PrintXDreams/BambuNRS/hardware/photos/1-1.png

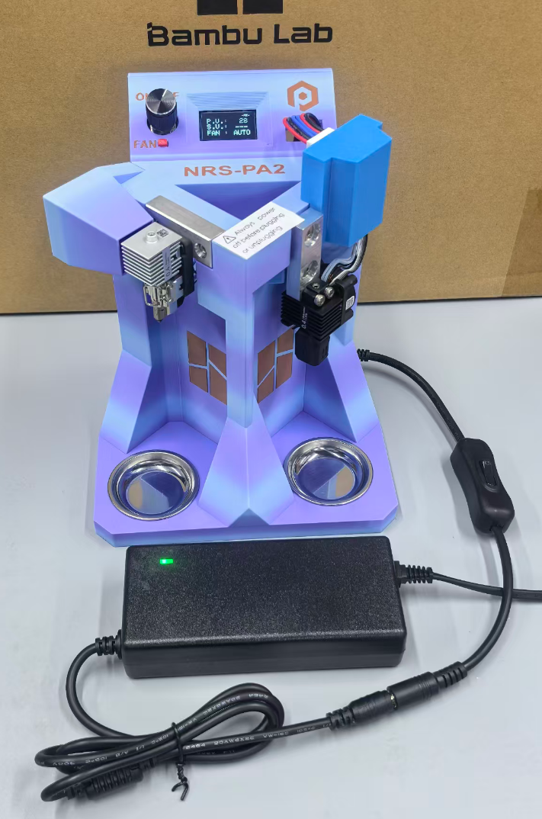
hardware/photos/1-1.png
