PrintXDreams/BambuNRS/hardware/photos/1-2.png

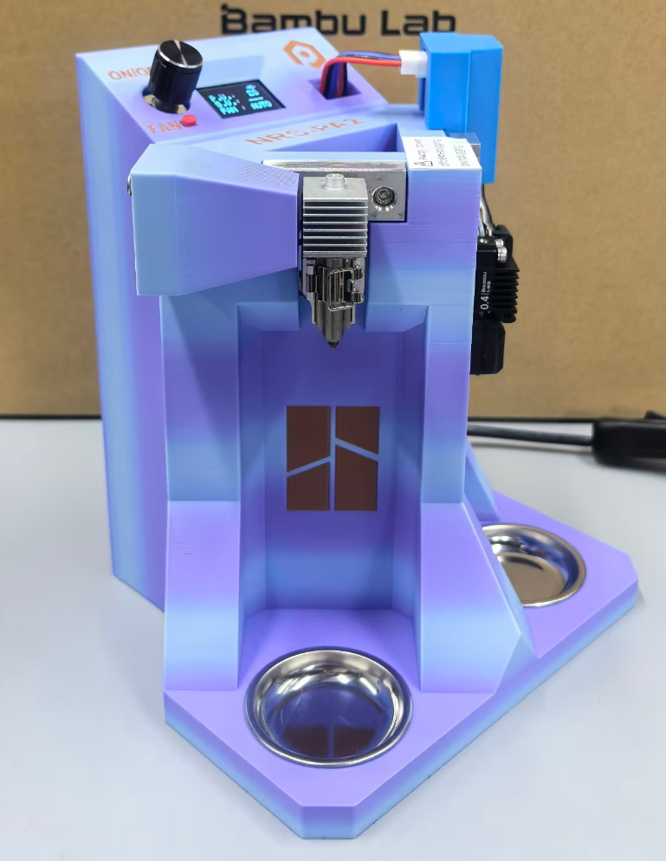
hardware/photos/1-2.png
