PrintXDreams/BambuNRS/hardware/photos/1-3.png

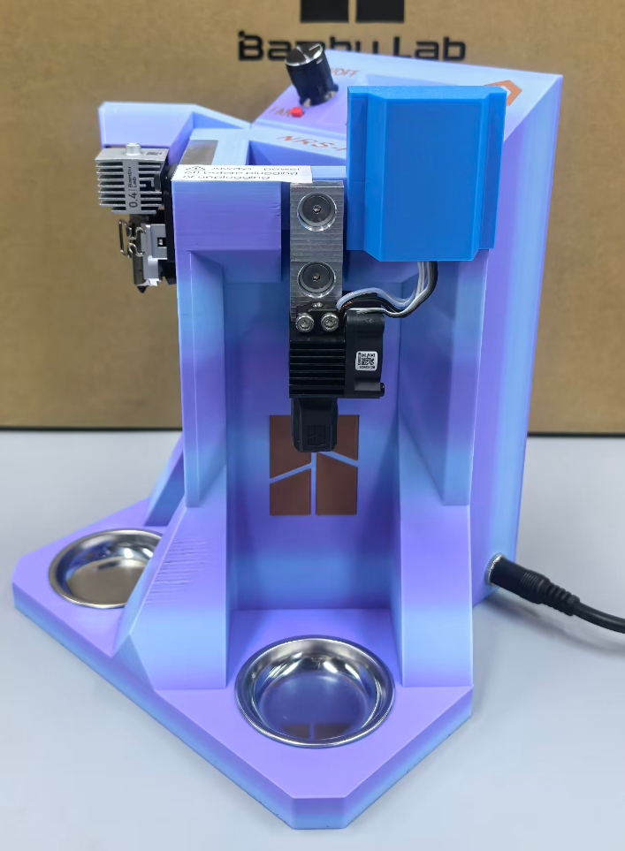
hardware/photos/1-3.png
