PrintXDreams/BambuNRS/hardware/photos/2-1.png

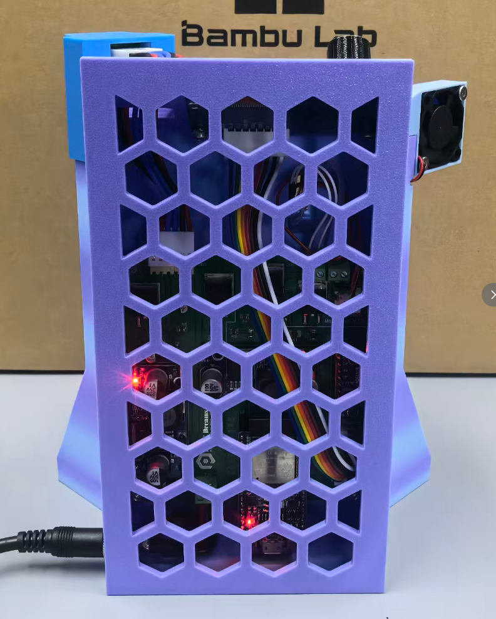
hardware/photos/2-1.png
