PrintXDreams/BambuNRS/hardware/photos/2-2.png

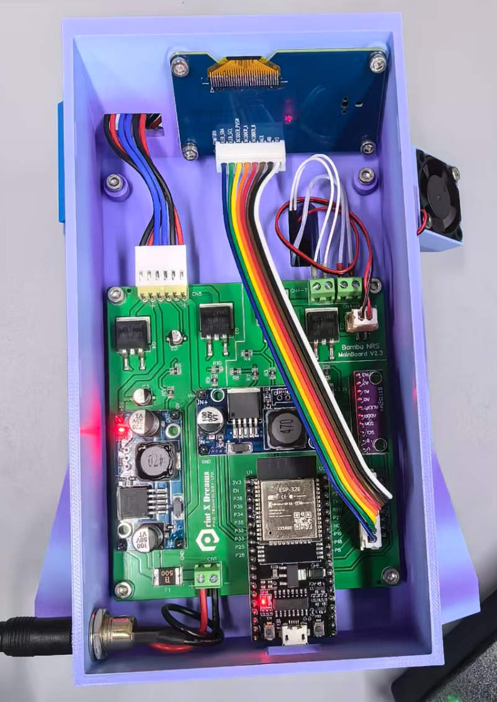
hardware/photos/2-2.png
