PrintXDreams/BambuNRS/hardware/photos/3-1.png

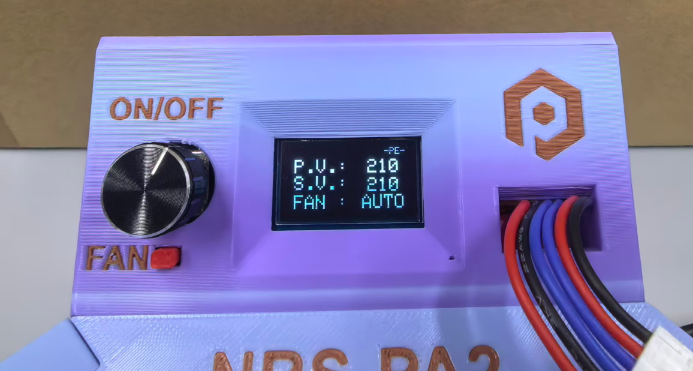
hardware/photos/3-1.png
