PrintXDreams/BambuNRS/hardware/photos/3-2.png

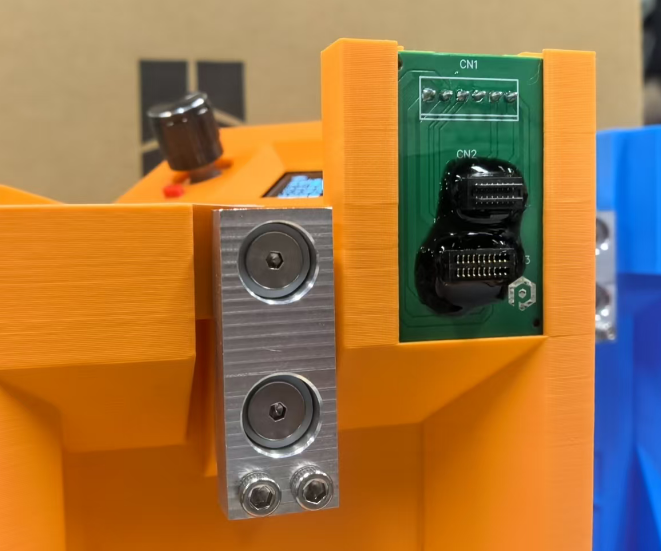
hardware/photos/3-2.png
