PrintXDreams/BambuNRS/hardware/photos/3-3.png

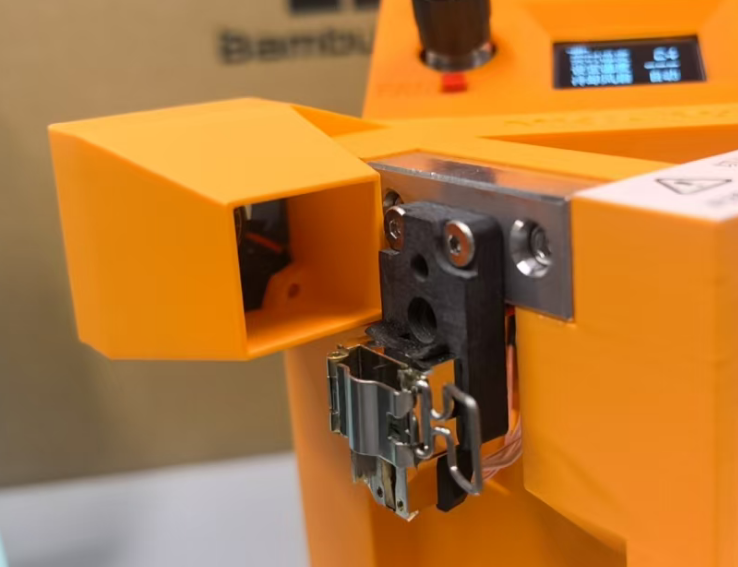
hardware/photos/3-3.png
