PrintXDreams/BambuNRS/hardware/photos/3-4.png

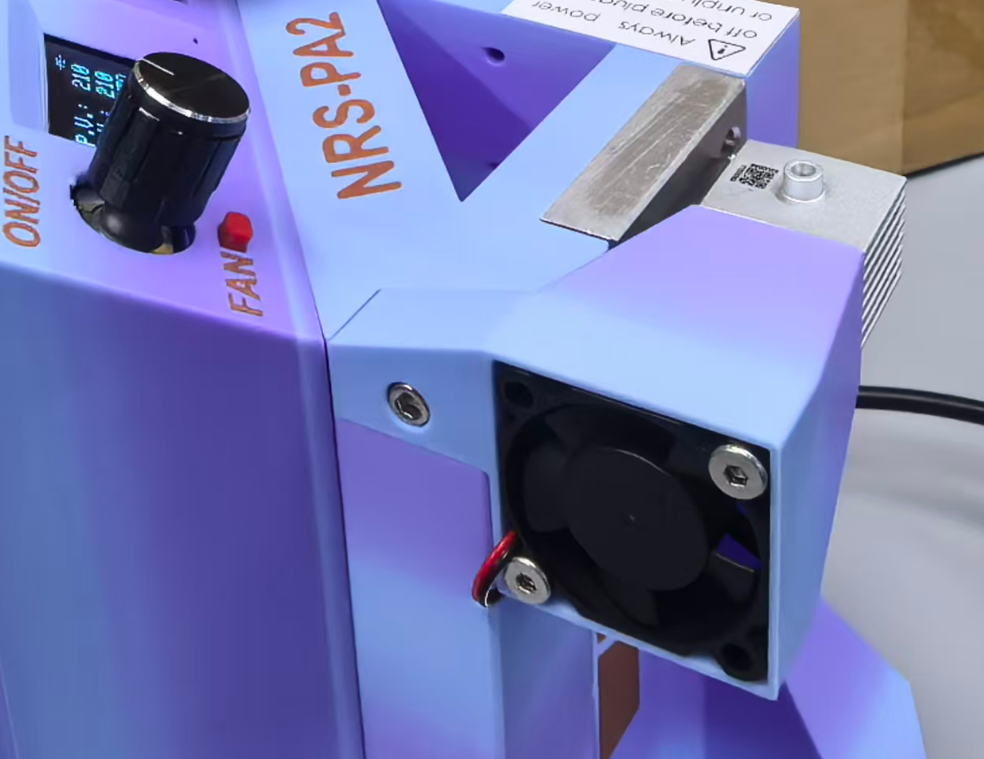
hardware/photos/3-4.png
