PrintXDreams/BambuNRS/hardware/photos/5-1.png

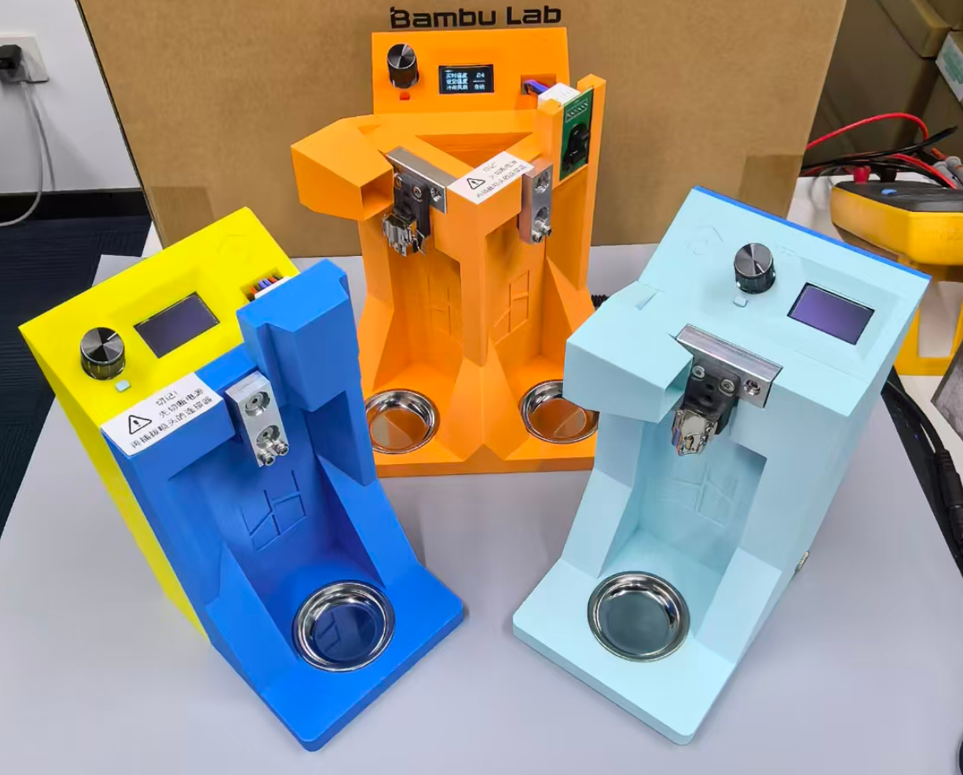
hardware/photos/5-1.png
