PrintXDreams/BambuNRS/docs/assembly/parts-selection.md

# Parts Selection Notes

> [!NOTE]
> Work in progress - content will be added incrementally.

## Electronics

### ESP32 Development Board

**Model:** ESP-32-32E

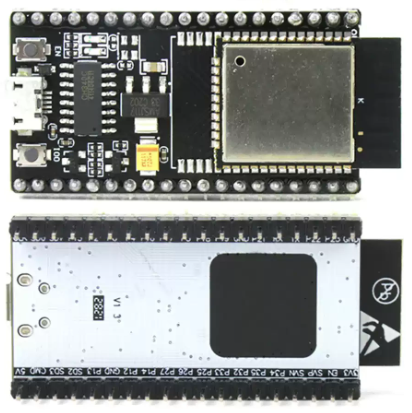
[picture p12: docs/assembly/img/esp32-devkit.png]
ESP-32-32E


<!-- Notes on ESP32 -->

### OLED Display + Rotary Encoder Module

**Model:** 0.96" OLED Display + EC11 Rotary Encoder Combo Module with IIC Interface

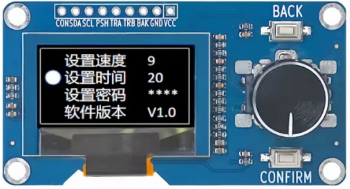
[picture p13: docs/assembly/img/oled-rotary-encoder-module.png]
OLED+EC11


<!-- Notes on OLED and rotary encoder -->

### DC-DC Buck Power Module

**Model:** LM2596S Fixed Output 3.3V / LM2596S Fixed Output 5V (P-series only), 3A

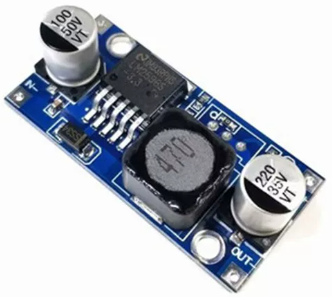
[picture p14: docs/assembly/img/lm2596-dc-dc-module.png]
LM2596


<!-- Notes on DC-DC module -->

### DC Cooling Fan (A-series only)

**Model:** 2510, 24VDC, XH2.54 Connector

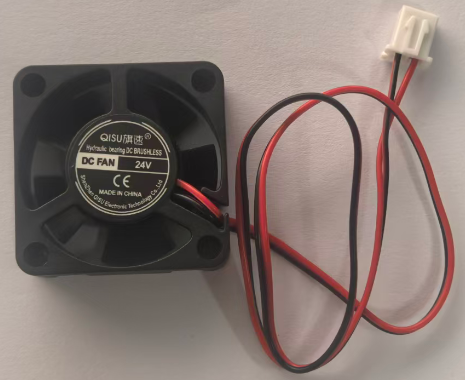
[picture p15: docs/assembly/img/dc-fan-2510.png]
DC Fan 2510


<!-- Notes on DC fan -->

### A1 Hotend Heater Component

**Model:** FAH012 (Third-party compatible)

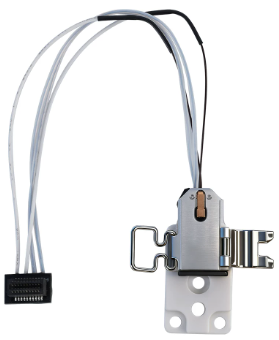
[picture p16: docs/assembly/img/fah012-heater.png]
FAH012


<!-- Notes on A1 hotend heater -->

### DC Power Supply

**Model:** 24V 5A, DC 5.5*2.5mm Connector

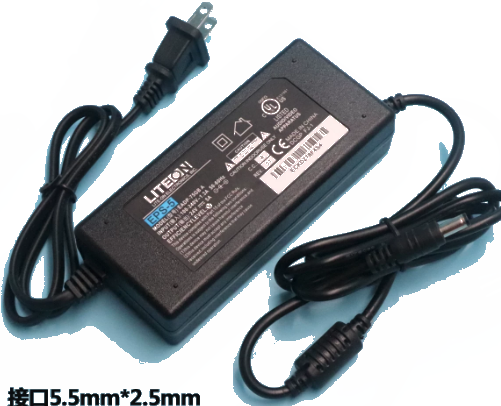
[picture p17: docs/assembly/img/dc-power-24v5a.png]
DC Power 24V5A


<!-- Notes on DC power supply -->

### DC Switch Cable

**Model:** DC 5.5*2.5mm, 5A

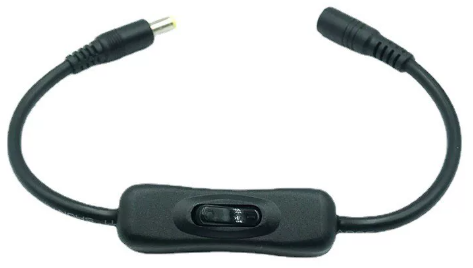
[picture p18: docs/assembly/img/dc-switch-cable.png]
DC Switch Cable


<!-- Notes on DC switch cable -->

### DC Power Socket

**Model:** DC-099, 5.5×2.5, with 10cm wire

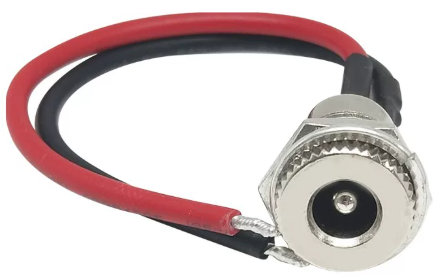
[picture p19: docs/assembly/img/dc-power-socket.png]
DC Power Socket


<!-- Notes on DC power socket -->

## Fasteners and Standard Parts

### Hexagon Socket Screws (内六角螺丝)

**Models:**
- M3×15 — For PCB mounting
- M3×12 — For A-series fan shroud, P-series hotend
- M3×5 — For OLED display

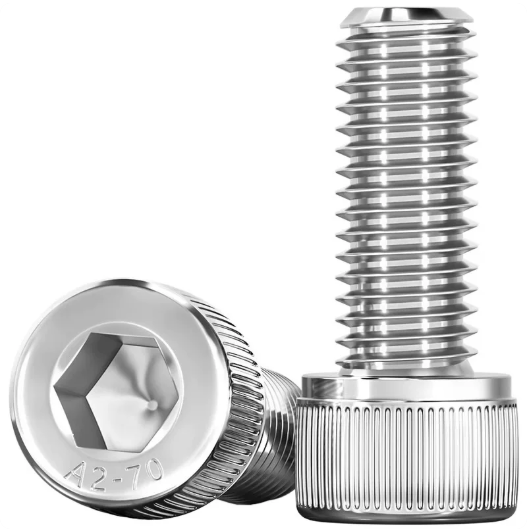
[picture p20: docs/assembly/img/m3-hex-screws.png]
M3 Hex Screws


<!-- Notes on M3 hex screws -->

### Flat Head Screws

**Models:**
- M3×14, Head Diameter 6mm, Head Thickness 1mm — For A-series cooling fan
- M3×16, Head Diameter 8mm, Head Thickness 1mm — For P-series hotend base

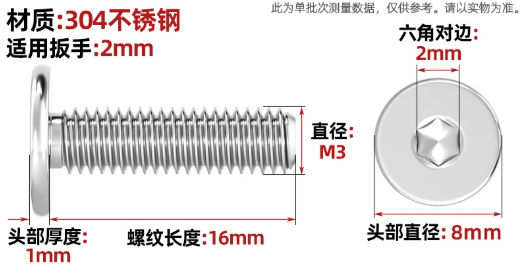
[picture p21: docs/assembly/img/m3-flat-head-screw-16.png]
M3 Flat Head Screw 16


<!-- Notes on flat head screws -->

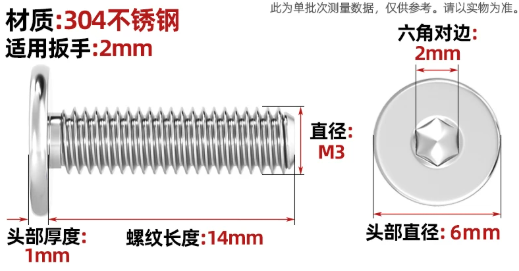
[picture p22: docs/assembly/img/m3-flat-head-screws.png]
M3 Flat Head


<!-- Notes on flat head screws -->

### PTFE High Temperature Washers

**Models:**
- 3×10×2 — For P-series hotend base
- 3×6×2 — For P-series hotend base

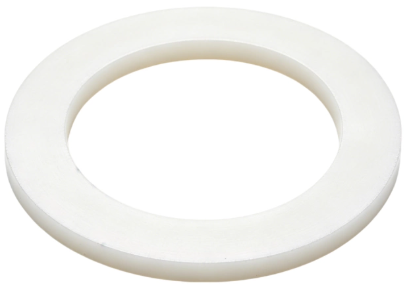
[picture p23: docs/assembly/img/ptfe-washers.png]
PTFE Washers


<!-- Notes on PTFE washers -->

### Nylon-Insulated Cord End Terminals (E Series)

**Models:**
- E0106 — For A-series heating component power wire
- E0206 — For A-series heating component NTC thermistor wire

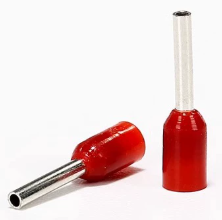
[picture p24: docs/assembly/img/e0106-terminal.png]
E0106 Terminal


<!-- Notes on E0106 terminals -->

## Miscellaneous

### Stainless Steel Small Dish (Optional)

**Specs:** Top diameter ~5cm, Bottom diameter ~3cm, Depth 0.5cm

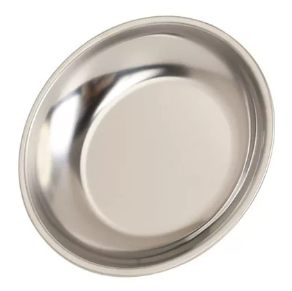
[picture p25: docs/assembly/img/stainless-steel-dish.png]
Stainless Steel Dish


<!-- Notes on stainless steel dish -->

---

*Last updated: 2026-06-10*
