PrintXDreams/BambuNRS/hardware/circuit/BOM_Bambu-NRS_V2.3.csv

ID | Name | Designator | Footprint | Quantity | Manufacturer Part | Manufacturer | Supplier | Supplier Part | Price
1 | 100uF | C3 | CAP-SMD_BD5.0-L5.3-W5.3-LS6.0-FD_RVT16V100M5X5 | 1 | RVT16V100M5X5 | JIERR(捷而瑞) | LCSC | C51953428 | 0.2752
2 | KF128L-3.81-2P | CN1,CN4-H,CN4-T | CONN-TH_P3.81_KF128L-3.81-2P | 3 | KF128L-3.81-2P | KEFA(科发) | LCSC | C474932 | 0.9811
3 | ESP32-V2R | U2 | ESP32 DEV BOARD FOR NRS V21-R | 1 | Unknow | 淘宝 | 淘宝 | Unknow
4 | ESP32-V2L | U1 | ESP32 DEV BOARD FOR NRS V21-L | 1 | Unknow | 淘宝 | 淘宝 | Unknow
5 | ADS1115模块-TH | U5 | ADS1115模块封装-TH | 1 |  |  | 淘宝
6 | 10Ω | R3,R5,R7,R9 | R0805 | 4 | SC0805J10R0G4ANRH | Sunway(信维通信) | LCSC | C3152219 | 0.0079
7 | KF2510-6AW | CN5 | MYCONN-TH_6P-P2.54_KF2510-6AW | 1 | 2510-6A平弯 | BOOMELE(博穆精密) | LCSC | C458120 | 0.2468
8 | ZX-XH2.54-8PLT | CN2 | CONN-SMD_8P-P2.50_ZX-XH2.54-8PLT-1 | 1 | ZX-XH2.54-8PLT | Megastar(兆星) | LCSC | C7429686 | 0.7324
9 | ZX-XH2.54-2PLT | CN3 | CONN-SMD_2P-P2.50_HCTL_HC-XH-2ALT | 1 | ZX-XH2.54-2PLT | Megastar(兆星) | LCSC | C7429680 | 0.4545
10 | 2920L500/30GR | F1 | F2920 | 1 | 2920L500/30GR | LUTE(陆特) | LCSC | C19078763 | 0.98
11 | IRLZ44NSPBF-VB | Q1,Q2,Q3,Q4 | TO-263-3_L10.2-W9.2-P5.08-LS15.4-BR | 4 | IRLZ44NSPBF-VB | VBsemi(微碧半导体) | LCSC | C19188232 | 4.86
12 | M3铜柱_LCEDA | TP1,TP2,TP3,TP4 | M3铜柱_LCEDA | 4 |  |  | LCSC
13 | 100kΩ | R4,R6,R8,R10 | R0805 | 4 | RCA05100KJLF | HKR(香港电阻) | LCSC | C22356675 | 0.008
14 | LM2596S-5V DC-DC 模块 | U3 | LM2596S-5V-DC MODULE | 1 | DC-DC-250314 | PXD |  | myDC-DC
15 | LM2596S-3V3 DC-DC 模块 | U4 | LM2596S-3V3-DC MODULE | 1 | DC-DC-250314 | PXD |  | myDC-DC
16 | 4.7uF | C1,C2 | CAP-SMD_BD4.0-L4.3-W4.3-LS5.0-FD | 2 | VT50V4R7M4X5 | 捷而瑞 | LCSC | C48970985 | 0.1932
17 | 4.7kΩ | R1,R2 | R1206 | 2 | RT1206BRD074K7L | YAGEO(国巨) | LCSC | C728676 | 0.3603
