PrintXDreams/BambuNRS/hardware/circuit/BOM_Bambu-NRS_Interface_V1.1.csv

ID | Name | Designator | Footprint | Quantity | Manufacturer Part | Manufacturer | Supplier | Supplier Part | Price
1 | SGDBF-08-20P-H40 | CN3 | CONN-SMD_BTB08-2-10-F-H40 | 1 | HC-PBB08-2-08-M-H4.0-G1-R-P-04 | HCTL(华灿天禄) | LCSC | C41421136 | 1.9242
2 | 2510-6A | CN1 | CONN-TH_6P-P2.54_CAX_2510-6A | 1 | 2510-6A | CAX(创都) | LCSC | C2847672 | 0.2432
3 | SGDBM-08-16P-H40 | CN2 | CONN-SMD_BTB08-2-08-M-H40 | 1 | HC-PBB08-2-08-M-H4.0-G1-R-P-04 | HCTL(华灿天禄) | LCSC | C41421136 | 1.9242
