PrintXDreams/BambuNRS/docs/assembly/assembly.md

# Assembly Guide

> [!NOTE]
> Work in progress - tips and notes will be added incrementally.

## Assembly Tips

### NRS Interface Board

**Tip 1:** Apply glue to secure connectors on the Interface Board. Use electronic assembly adhesive to prevent connector sockets from falling off or getting damaged due to frequent plugging and unplugging.

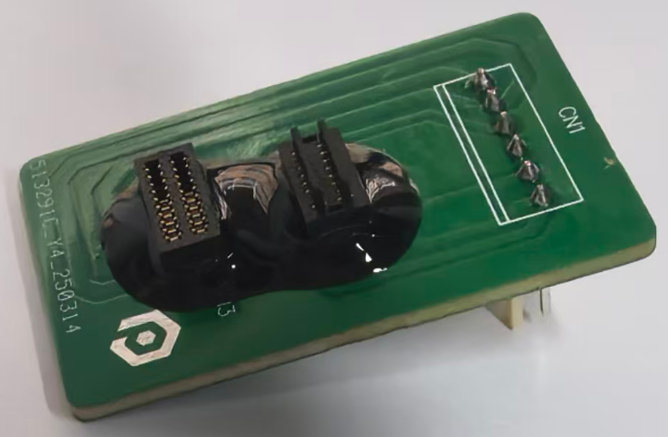
[picture p26: docs/assembly/img/interface-board-connector-glue.png]
Interface Board Connector Glue


**Tip 2:** Use KF2510 terminals and silicone wire to ensure current capacity above 3A.

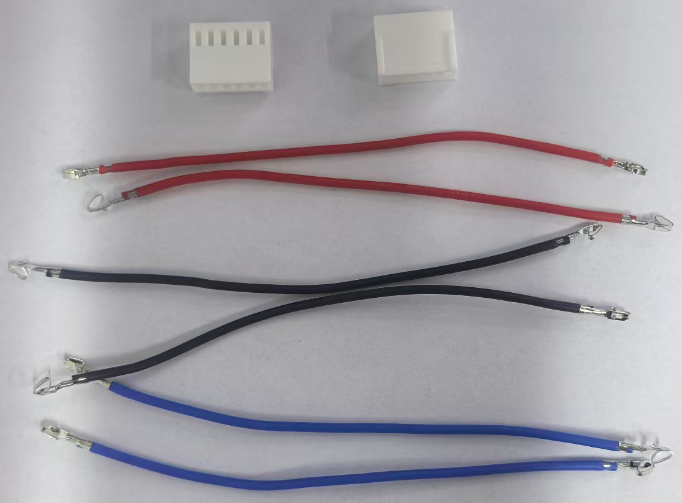
[picture p27: docs/assembly/img/kf2510-silicone-wire.png]
KF2510 Silicone Wire


**Tip 3:** After connecting the Interface Board.

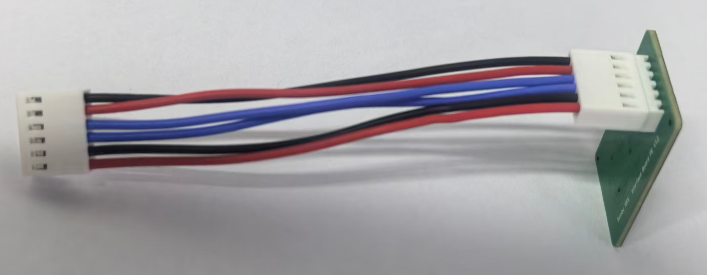
[picture p28: docs/assembly/img/interface-board-connected.png]
Interface Board Connected


<!-- More tips for NRS Interface Board -->

### OLED Screen Wiring

**Tip 1:** Use XH2.54-8P connector. Leave CONFIRM pin empty.

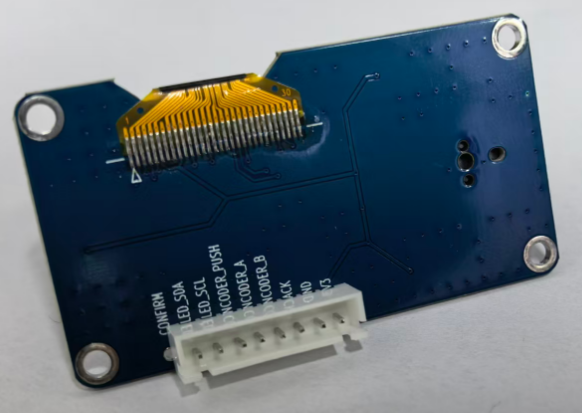
[picture p29: docs/assembly/img/oled-xh2.54-8p.png]
OLED XH2.54-8P


<!-- More tips for OLED screen wiring -->

### Fan Wire Routing

**Tip 1:** Cut off the fan wire clip support with a carving knife.

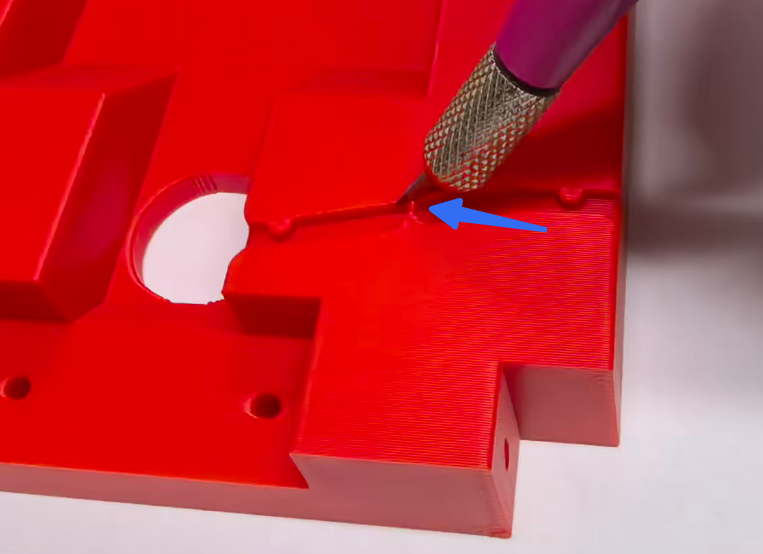
[picture p30: docs/assembly/img/fan-wire-clip-cut.png]
Fan Wire Clip Cut


**Tip 2:** Fan wire routing example.

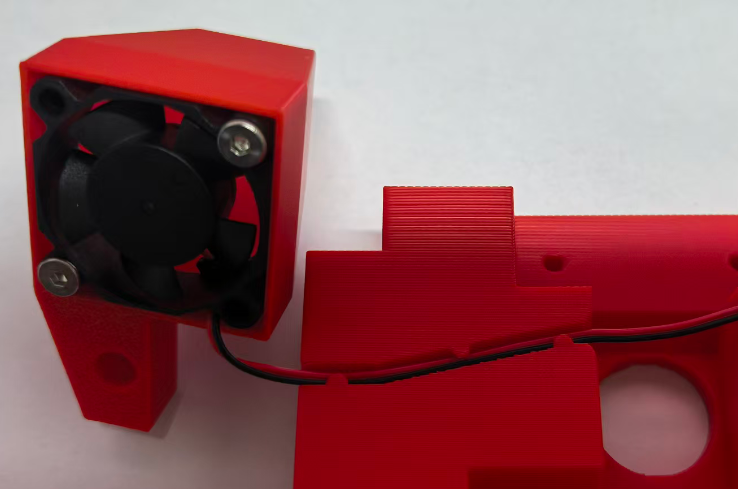
[picture p31: docs/assembly/img/fan-wire-routing-example.png]
Fan Wire Routing Example


<!-- More tips for fan wire routing -->

### P-Series Hotend Base Mounting

**Tip 1:** Required parts: M3×16 hex screws, Head Diameter 8mm, Head Thickness 1mm (×2), PTFE washers 3×10×2 (×4), PTFE washers 3×6×2 (×4).

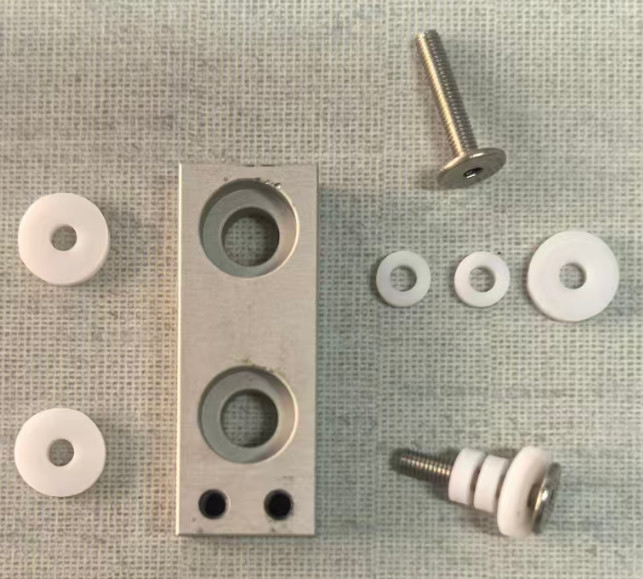
[picture p32: docs/assembly/img/p-hotend-parts.png]
P-Series Hotend Parts


**Tip 2:** Place the hotend base onto the mounting bracket. Insert M3×16 screws through the base holes and into the bracket.

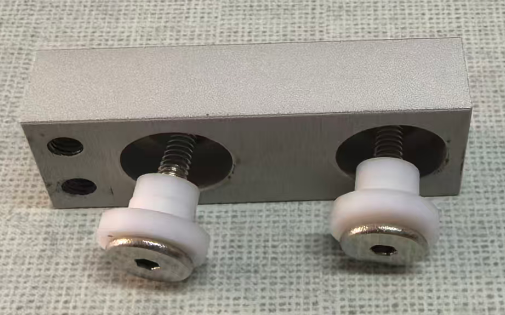
[picture p33: docs/assembly/img/p-hotend-assembly-1.png]
P-Series Hotend Assembly 1


**Tip 3:** Insert PTFE washers onto the screws before securing. Place 3×10×2 washers on the outer positions and 3×6×2 washers on the inner positions.

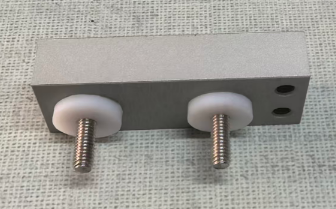
[picture p34: docs/assembly/img/p-hotend-assembly-2.png]
P-Series Hotend Assembly 2


**Tip 4:** The PTFE washers are placed between the metal hotend base and the 3D printed frame to prevent heat transfer from the hotend to the printed model.

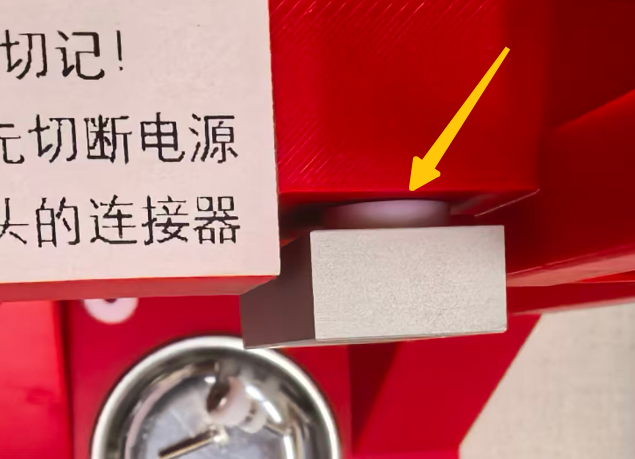
[picture p35: docs/assembly/img/p-hotend-assembly-4.png]
P-Series Hotend Assembly 4


---

*Last updated: 2026-06-10*
