PrintXDreams/BambuNRS/hardware/structure/A-Nozzle Base-v1_3A.pdf

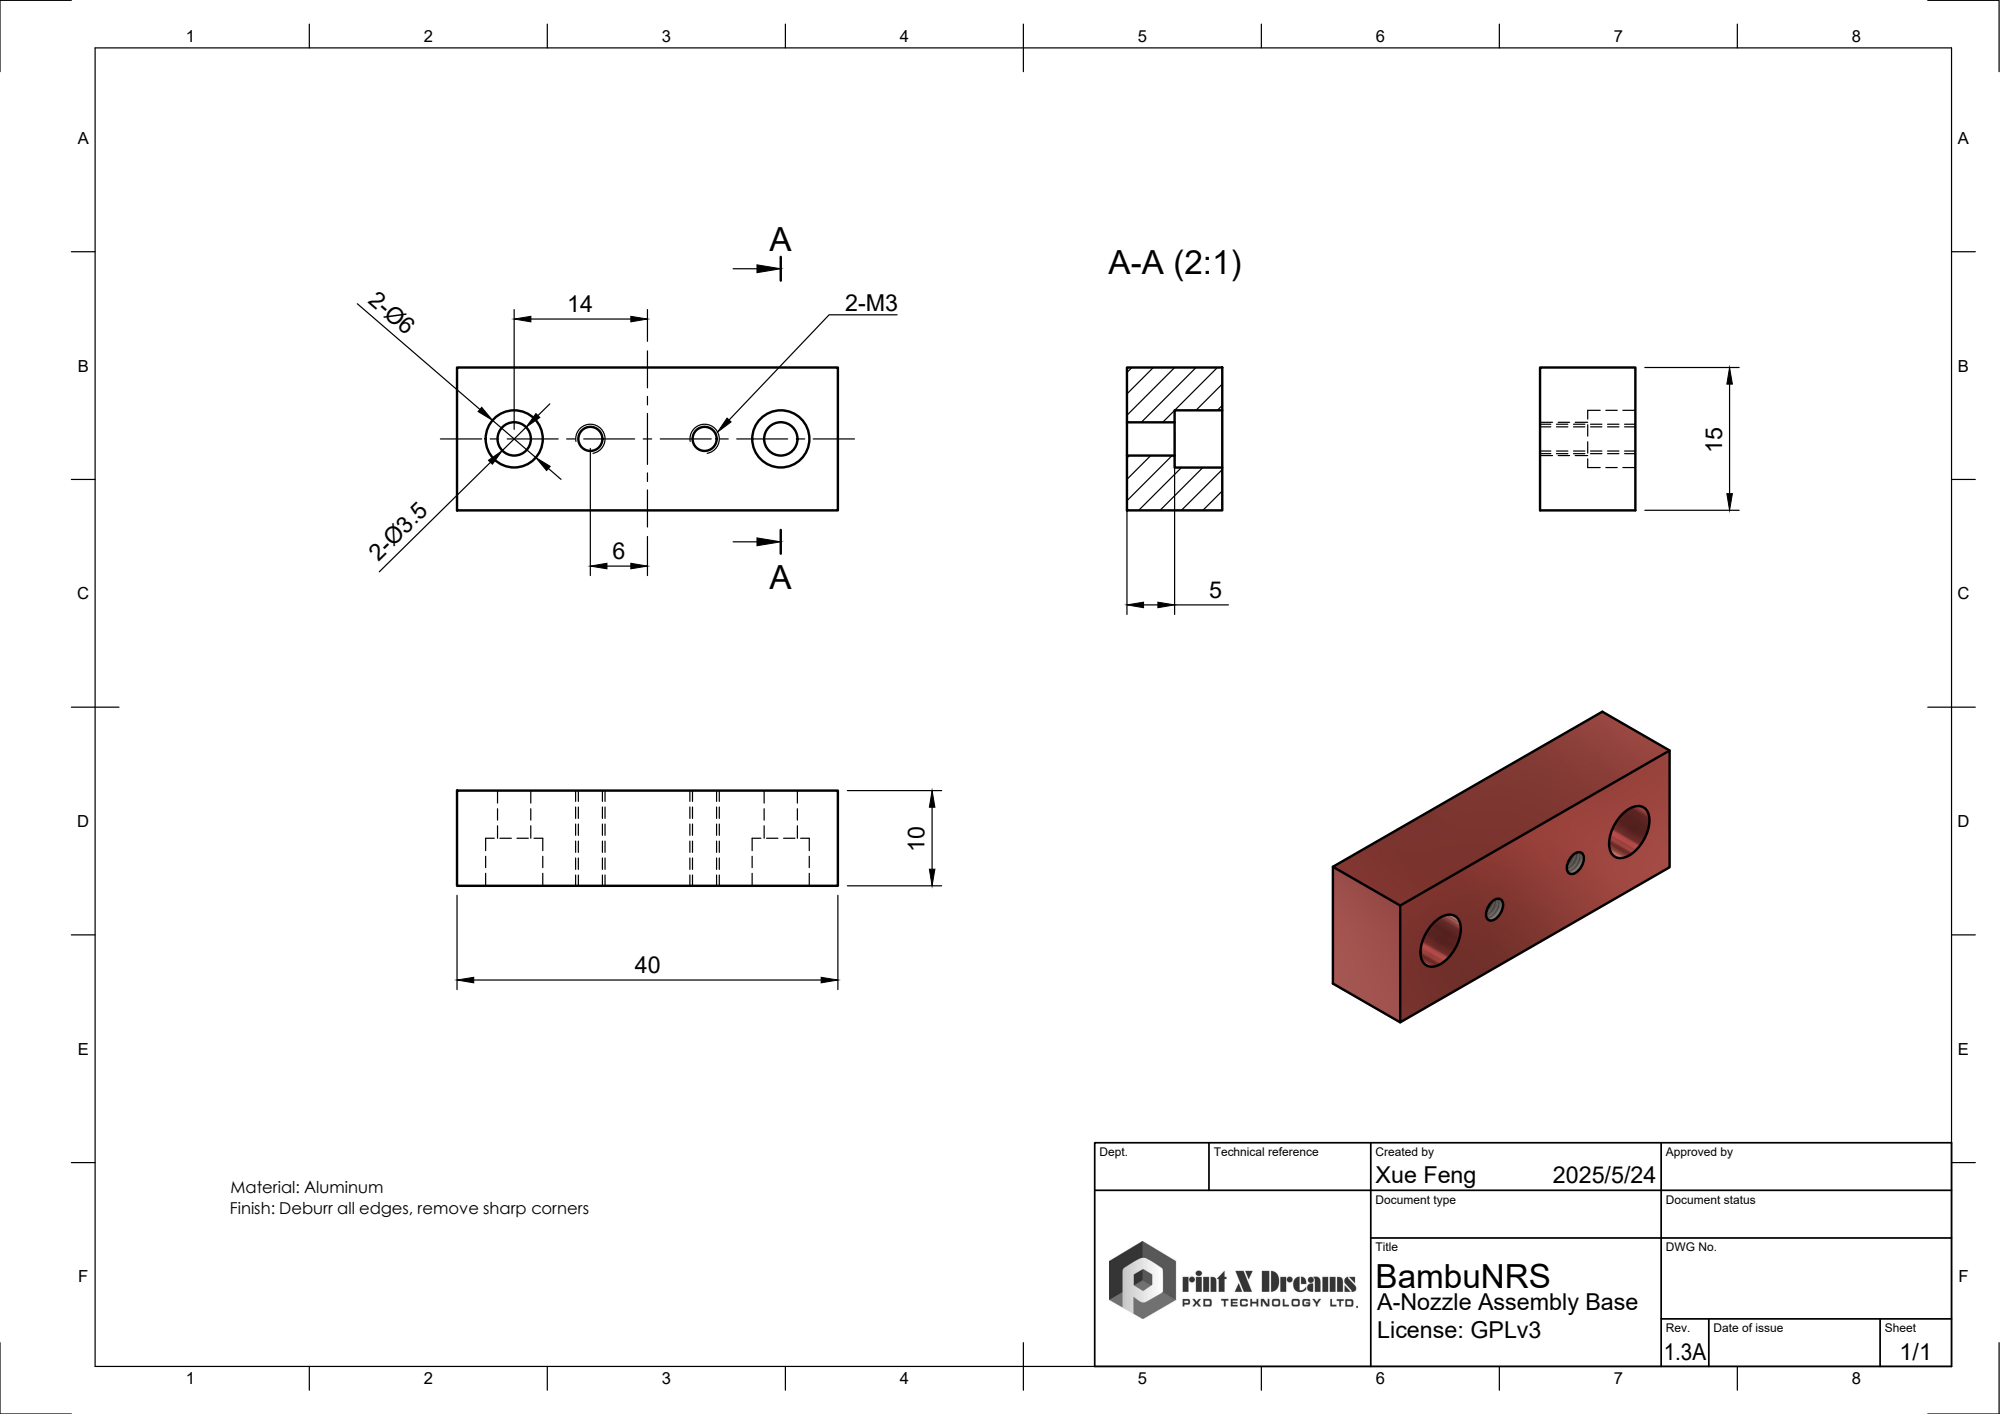
[picture p36: page 1]

Dept. | Technical reference | Created by 2025/5/24 | Approved by

Xue Feng Material: Aluminum

Finish: Deburr all edges, remove sharp corners

Document type | Document status

Title BambuNRS A-Nozzle Assembly Base License: GPLv3 | DWG No.

Rev. 1.3A | Date of issue | Sheet 1/1
