PrintXDreams/BambuNRS/hardware/structure/P-Nozzle Base-v1_1.pdf

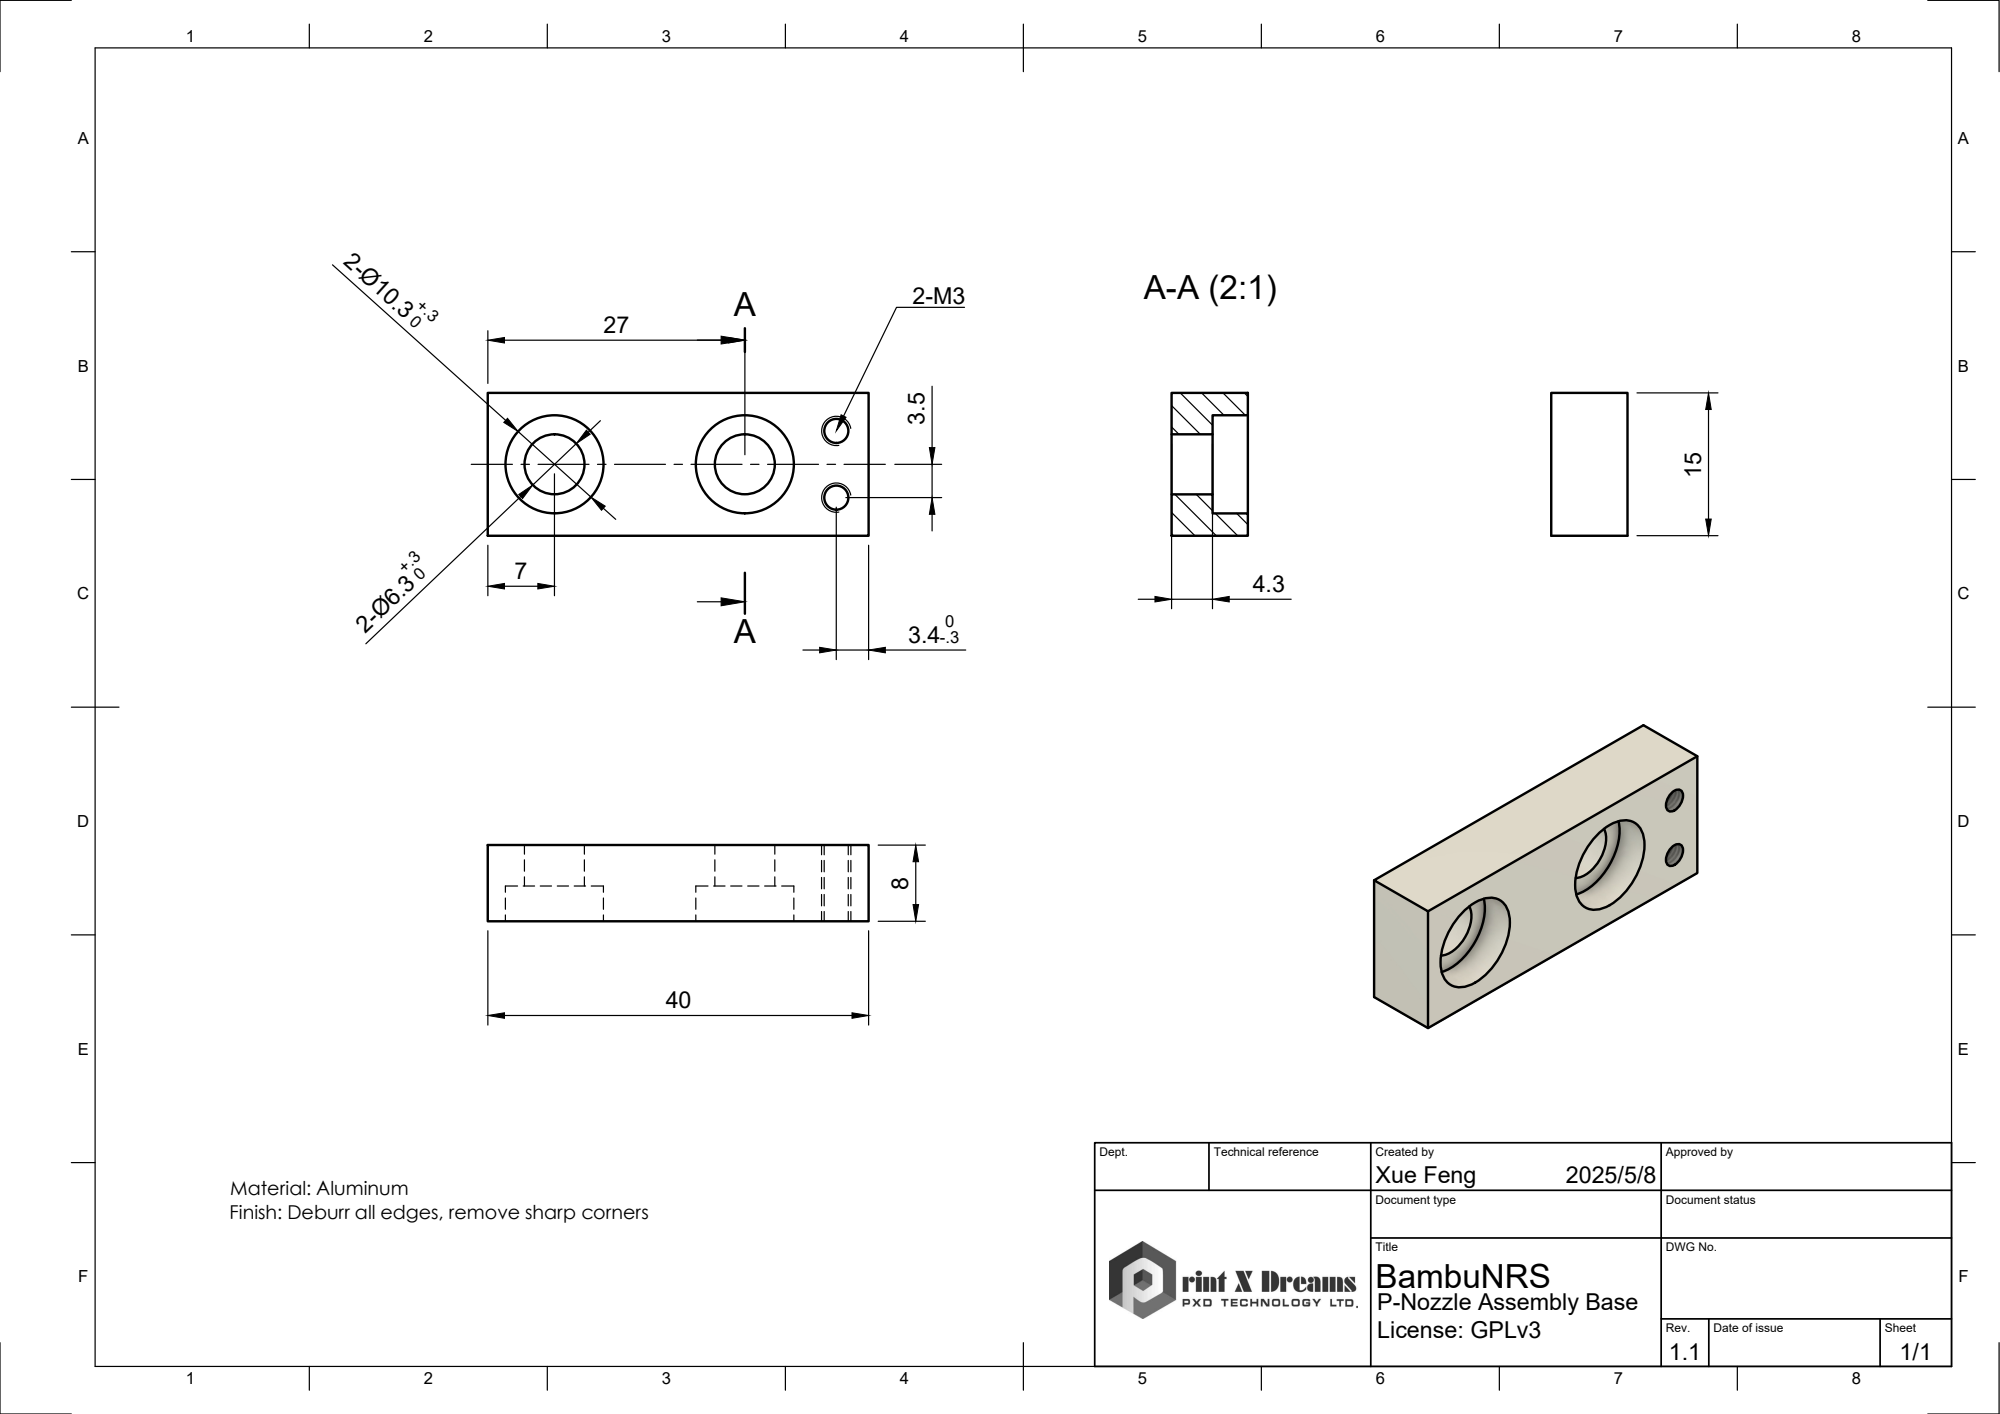
[picture p37: page 1]

Dept. | Technical reference | Created by 2025/5/8 | Approved by

Xue Feng Material: Aluminum

Document type | Document status

Finish: Deburr all edges, remove sharp corners

Title BambuNRS P-Nozzle Assembly Base License: GPLv3 | DWG No.

Rev. 1.1 | Date of issue | Sheet 1/1
