PrintXDreams/BambuNRS/hardware/circuit/Schematic_Bambu-NRS_V2.3.pdf

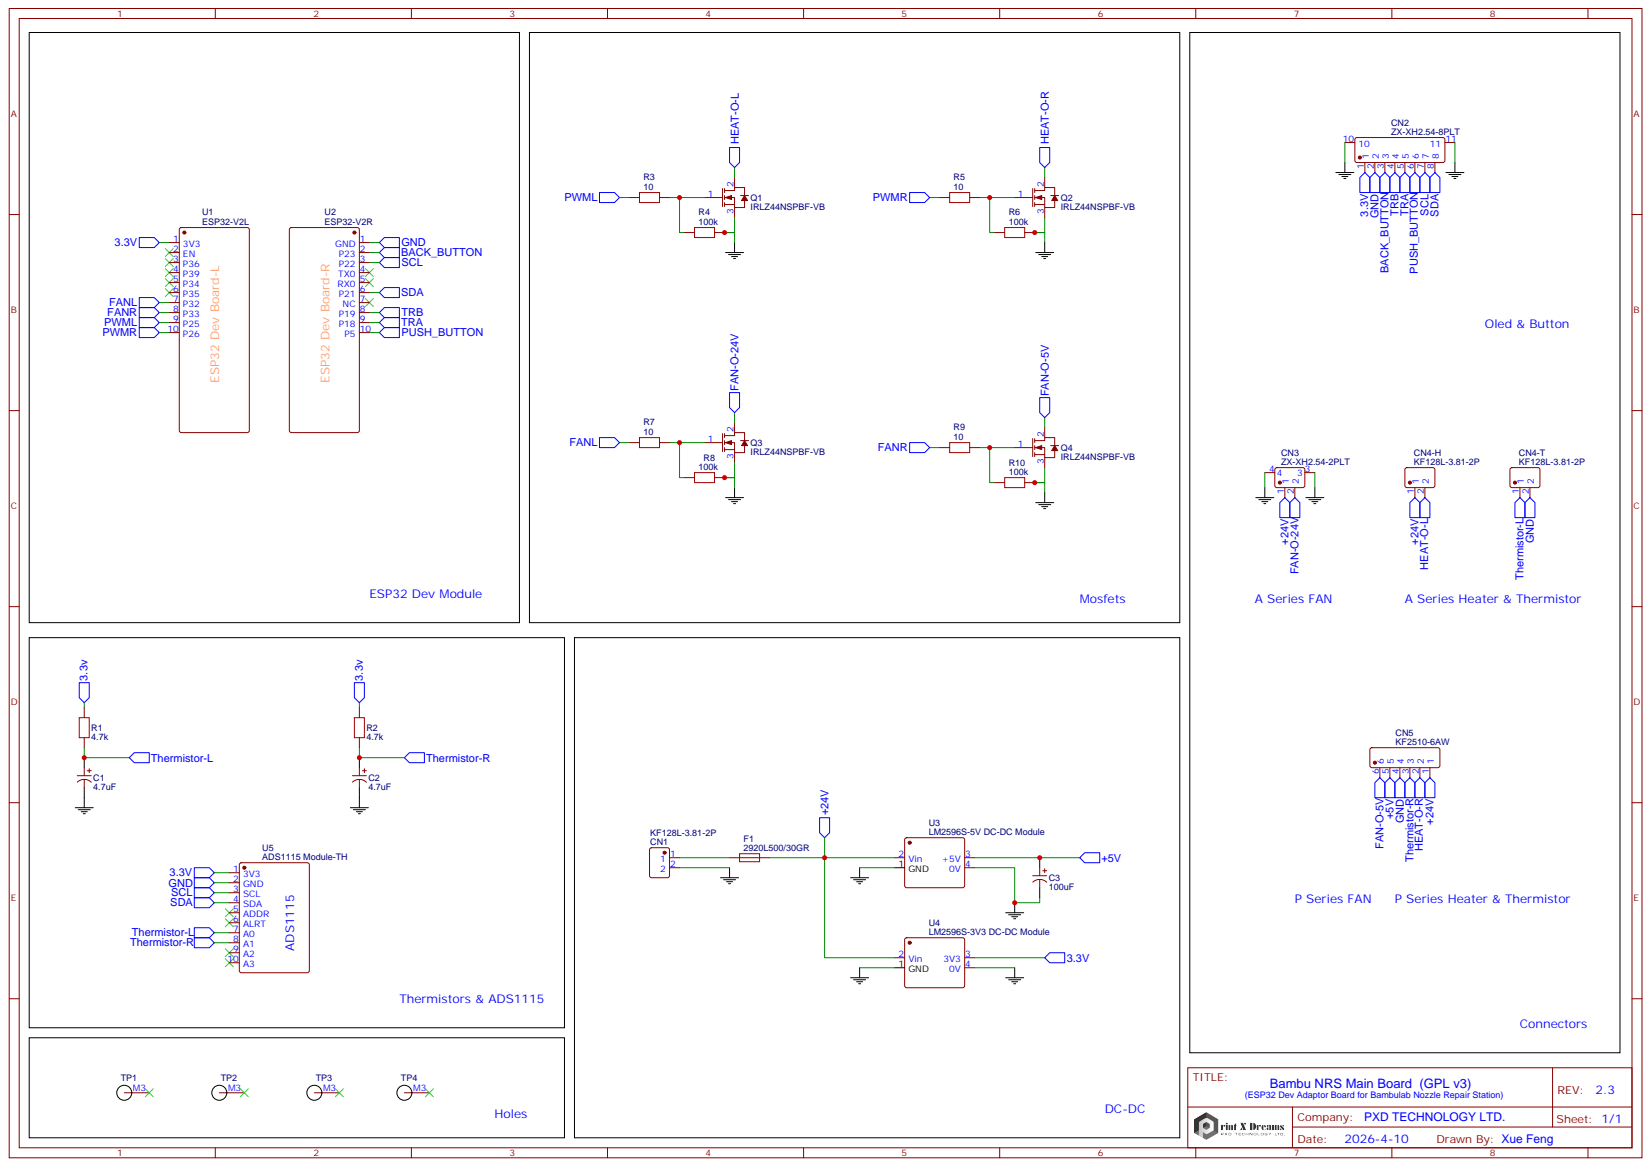
[picture p38: page 1]

Bambu NRS Main Board (GPL v3)
(ESP32 Dev Adaptor Board for Bambulab Nozzle Repair Station)

Company: PXD TECHNOLOGY LTD.

Drawn By: Xue Feng
