PrintXDreams/BambuNRS/hardware/circuit/Schematic_Bambu-NRS_Interface_V1.1.pdf

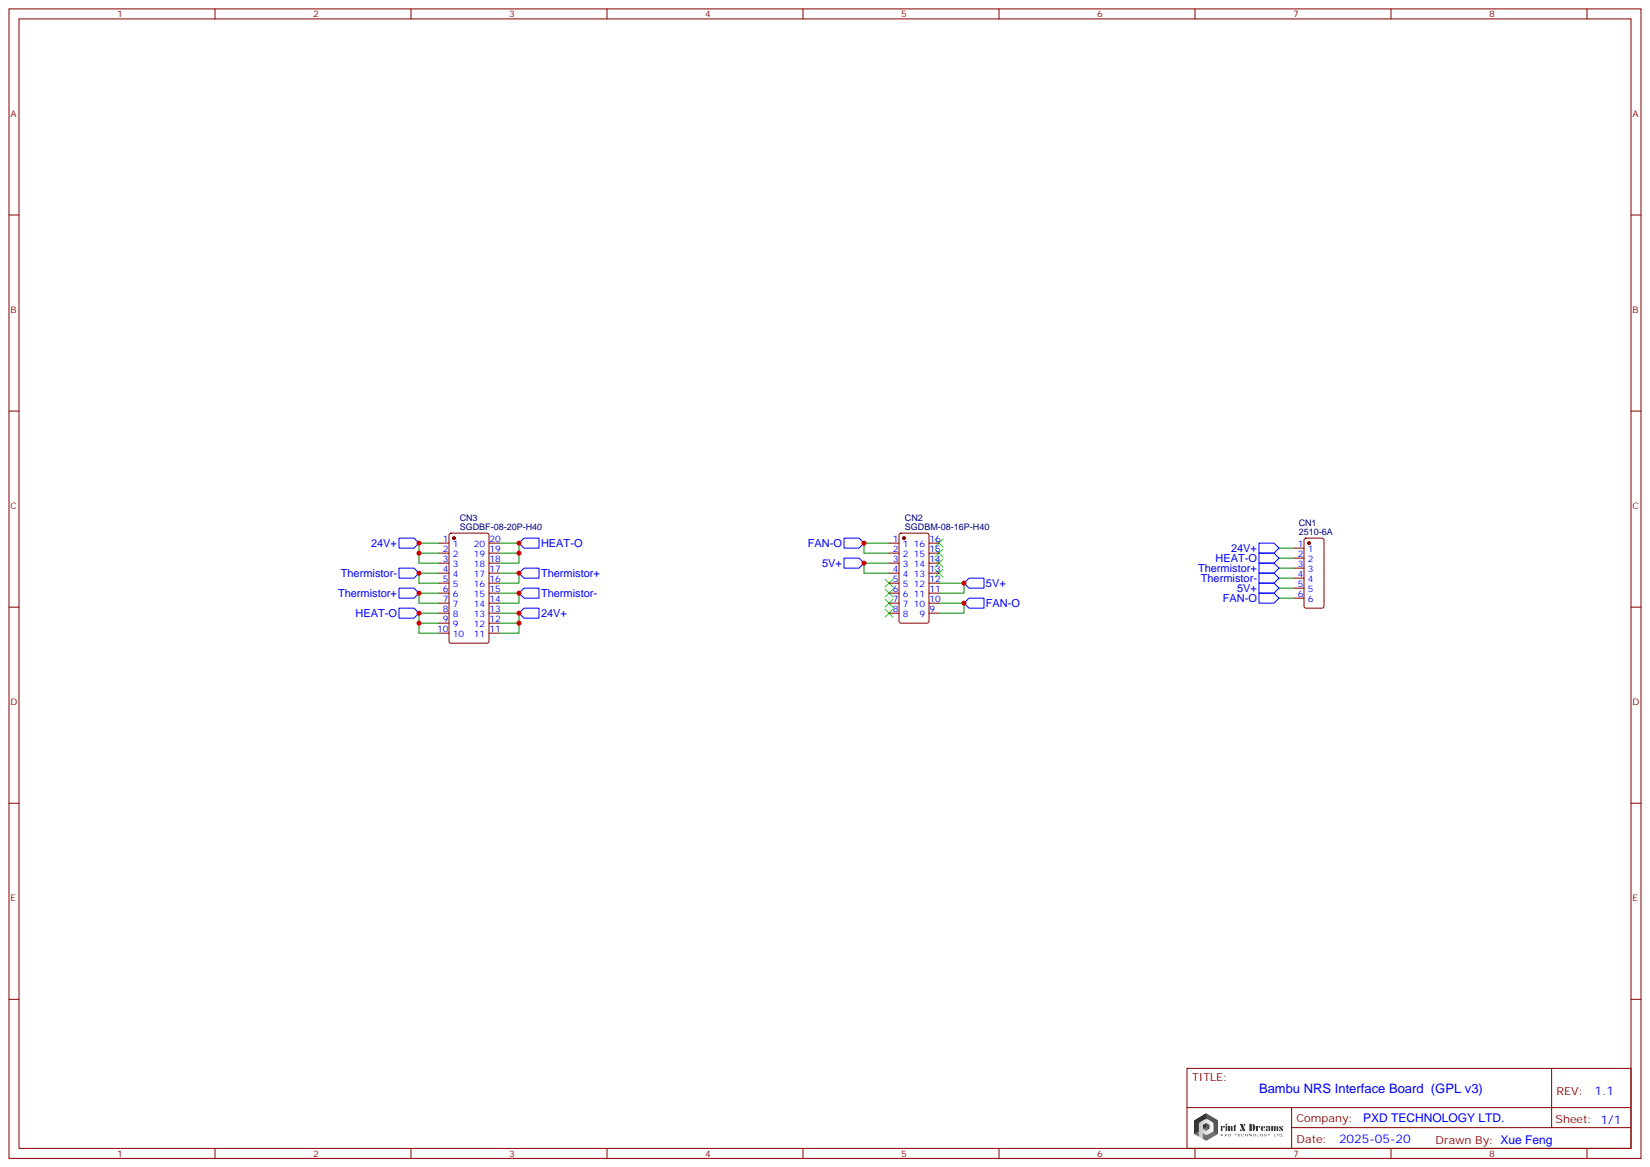
[picture p39: page 1]

Company: PXD TECHNOLOGY LTD.

Drawn By: Xue Feng
