PrintXDreams/BambuNRS/thermistortable_80.h

#define OVERSAMPLENR 1
//#define OVERSAMPLENR 25.78125
#define OV(N) int16_t((N)*(OVERSAMPLENR))

const short temptable_80[][2] PROGMEM = {
{ OV(12.7164),  360 },    //above 300, I added 4 date, total data qty from 61 to 65
{ OV(15.2599),  345},
{ OV(17.7906),  330 },
{ OV(20.3087),  315 },
{ OV(21.5),  300 },
{ OV(23.0625),  295 },
{ OV(24.8125),  290 },
{ OV(26.75),  285 },
{ OV(28.8125),  280 },
{ OV(31.125),  275 },
{ OV(33.625),  270 },
{ OV(36.375),  265 },
{ OV(39.375),  260 },
{ OV(42.6875),  255 },
{ OV(46.3125),  250 },
{ OV(50.3125),  245 },
{ OV(54.6875),  240 },
{ OV(59.5625),  235 },
{ OV(64.875),  230 },
{ OV(70.75),  225 },
{ OV(77.25),  220 },
{ OV(84.4375),  215 },
{ OV(92.3125),  210 },
{ OV(101.0625),  205 },
{ OV(110.6875),  200 },
{ OV(121.3125),  195 },
{ OV(133),  190 },
{ OV(145.9375),  185 },
{ OV(160.125),  180 },
{ OV(175.6875),  175 },
{ OV(192.8125),  170 },
{ OV(211.5),  165 },
{ OV(231.9375),  160 },
{ OV(254.125),  155 },
{ OV(278.1875),  150 },
{ OV(304.125),  145 },
{ OV(332),  140 },
{ OV(361.6875),  135 },
{ OV(393.125),  130 },
{ OV(426.25),  125 },
{ OV(460.8125),  120 },
{ OV(496.5625),  115 },
{ OV(533.1875),  110 },
{ OV(570.3125),  105 },
{ OV(607.625),  100 },
{ OV(644.625),  95  },
{ OV(680.9375),  90  },
{ OV(716.125),  85  },
{ OV(749.875),  80  },
{ OV(781.8125),  75  },
{ OV(811.6875),  70  },
{ OV(839.25),  65  },
{ OV(864.5),  60  },
{ OV(887.3125),  55  },
{ OV(907.6875),  50  },
{ OV(925.6875),  45  },
{ OV(941.5),  40  },
{ OV(955.25),  35  },
{ OV(967),  30  },
{ OV(977.0625),  25  },
{ OV(985.5625),  20  },
{ OV(992.6875),  15  },
{ OV(998.625),  10  },
{ OV(1003.5625), 5 },
{ OV(1007.5625), 0 }
};
