PrintXDreams/BambuNRS/(commit log)

2026-05-27 Initial commit: BambuNRS v2.3
    [BOM_Bambu-NRS_Interface_V1.1.csv, BOM_Bambu-NRS_V2.3.csv, PickAndPlace_PCB_Bambu-NRS_Interface_V1.1.csv, PickAndPlace_PCB_Bambu-NRS_V2.3.csv]
2026-05-27 Add structure files: A-Nozzle Base v1.3A and P-Nozzle Base v1.1
2026-05-29 Add assembly guide link and MakerWorld 3D model download
    - Add note in Hardware section linking to Assembly Guide
    - Add Downloads section with MakerWorld link for 3D printable parts
2026-05-30 Add hardware photos and update README
    - Add 11 finished device photos (overall/back/detail/family views)
    - Move 3D Model section to Hardware Design area
    - Add Hardware Configurations section (AP Universal / A-Type / P-Type)
    - Add Gallery section with photo table
    - Add .gitignore for .claude/ directory
2026-05-30 Update README overview with professional terminology
    - Reword overview with dedicated station value proposition
    - Add Hot/Cold pull maintenance, Heat hex wrench unclogging, Cold pull
    - Add fan control as key station benefit
    - Use official Bambu Lab terminology from wiki.bambulab.com
2026-05-30 Add MakerWorld product description
    - Description with professional terminology (Hot/Cold pull, Heat hex wrench unclogging, Cold pull)
    - Includes Why BambuNRS section and all features
2026-06-03 Add ESP32 development board info and image to parts selection
2026-06-03 Add OLED display + rotary encoder module to parts selection
2026-06-03 Add DC cooling fan 2510 to parts selection
2026-06-03 Add FAH012 A1 hotend heater component to parts selection
2026-06-03 Add DC power supply 24V5A to parts selection
2026-06-03 Add DC switch cable and remove unused categories from parts selection
2026-06-03 Add M3 hex socket screws to fasteners section
2026-06-03 Add flat head screws and reorganize parts selection document
2026-06-03 Fix screw usage descriptions and update flat head screw notes
2026-06-03 Add M3x16 flat head screw for P-series hotend base
2026-06-03 Add PTFE high temperature washers for P-series hotend base
2026-06-03 Add DC-099 power socket to electronics section
2026-06-03 Add E series nylon cord end terminals for A-series heating component
2026-06-03 Simplify assembly guide to tips format
2026-06-03 Add assembly tips with images for NRS Interface Board, OLED wiring, and fan wire routing
2026-06-10 Add P-series hotend base mounting tips and stainless steel dish to parts selection
